GRMrGecko/Rotary-Gecko/Rotary Gecko.png

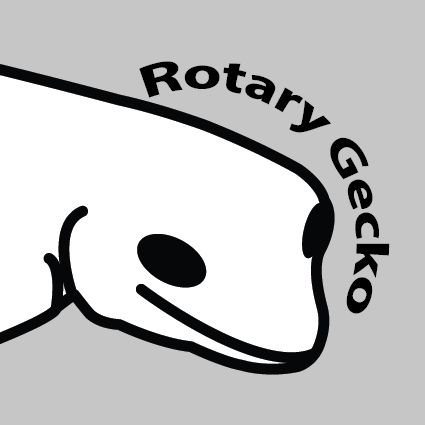
Rotary Gecko.png
