GRMrGecko/Rotary-Gecko/Schematic.jpeg

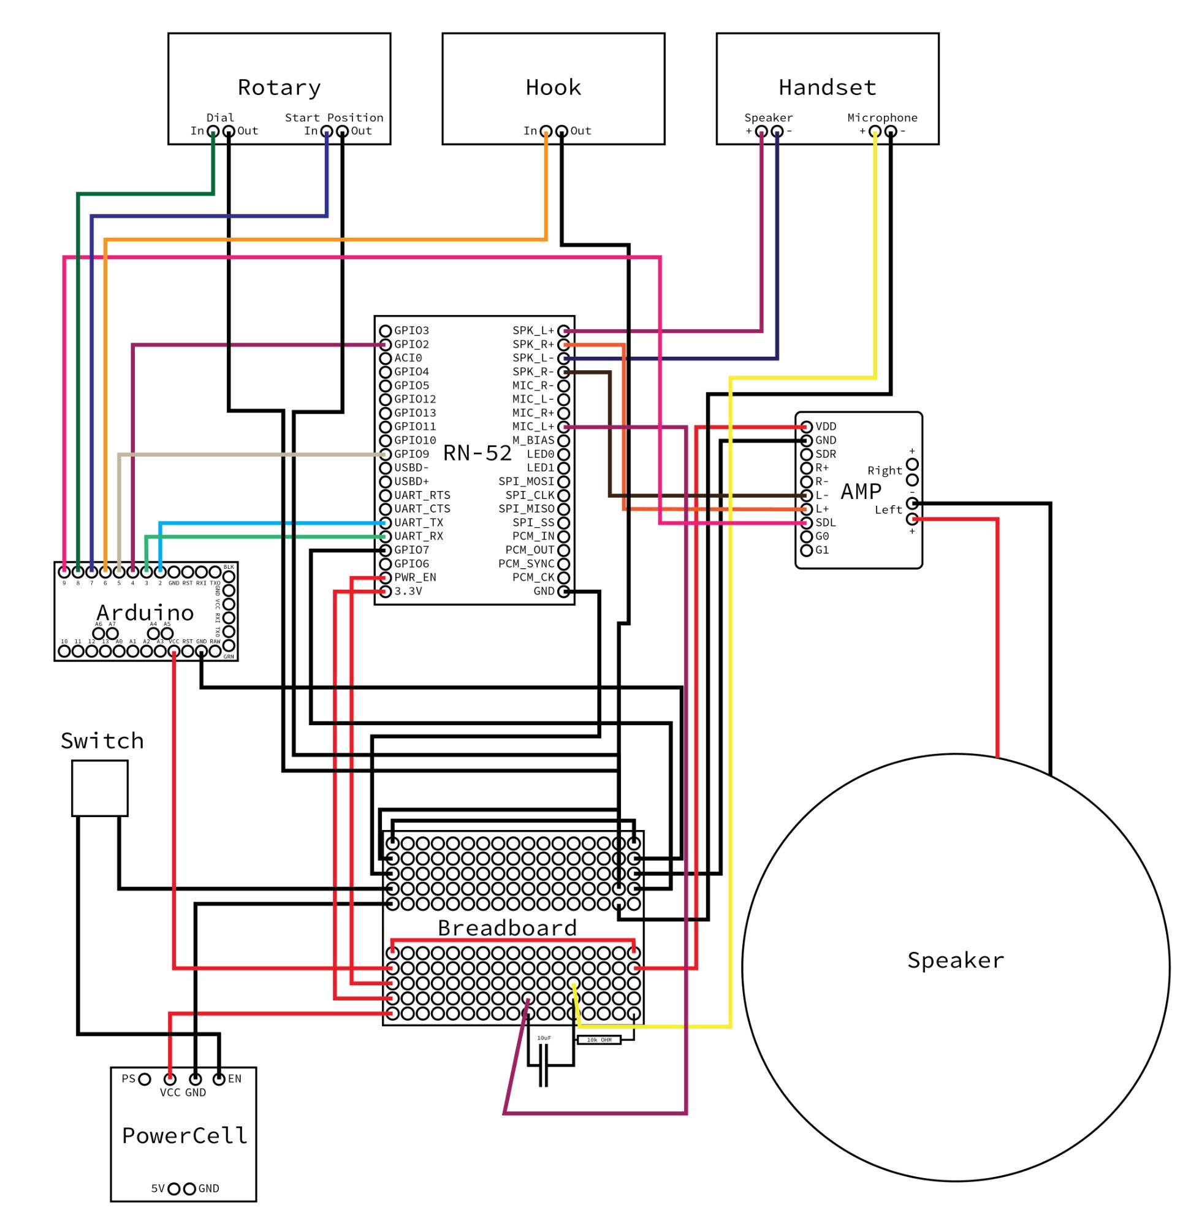
Schematic.jpeg
