GRMrGecko/Rotary-Gecko/Parts.numbers/preview-web.jpg

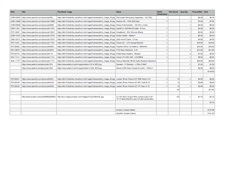
Parts.numbers/preview-web.jpg
